Fried-Electronics/FE2202-DRV8876-Breakout/KiCad/Pictures/221005 - 3D Rendering Angled.png

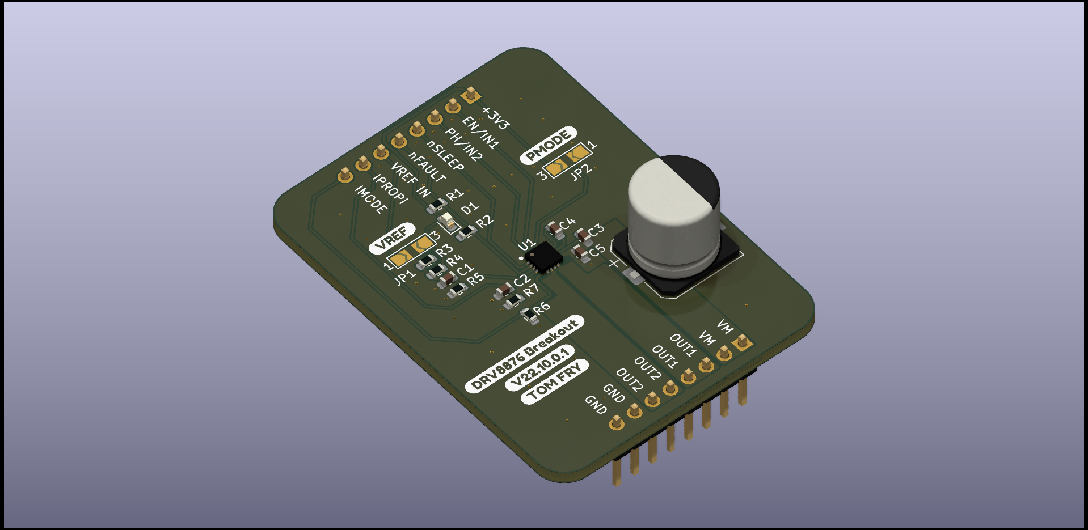
KiCad/Pictures/221005 - 3D Rendering Angled.png
