Fried-Electronics/FE2202-DRV8876-Breakout/KiCad/Pictures/221005 - Schematic.png

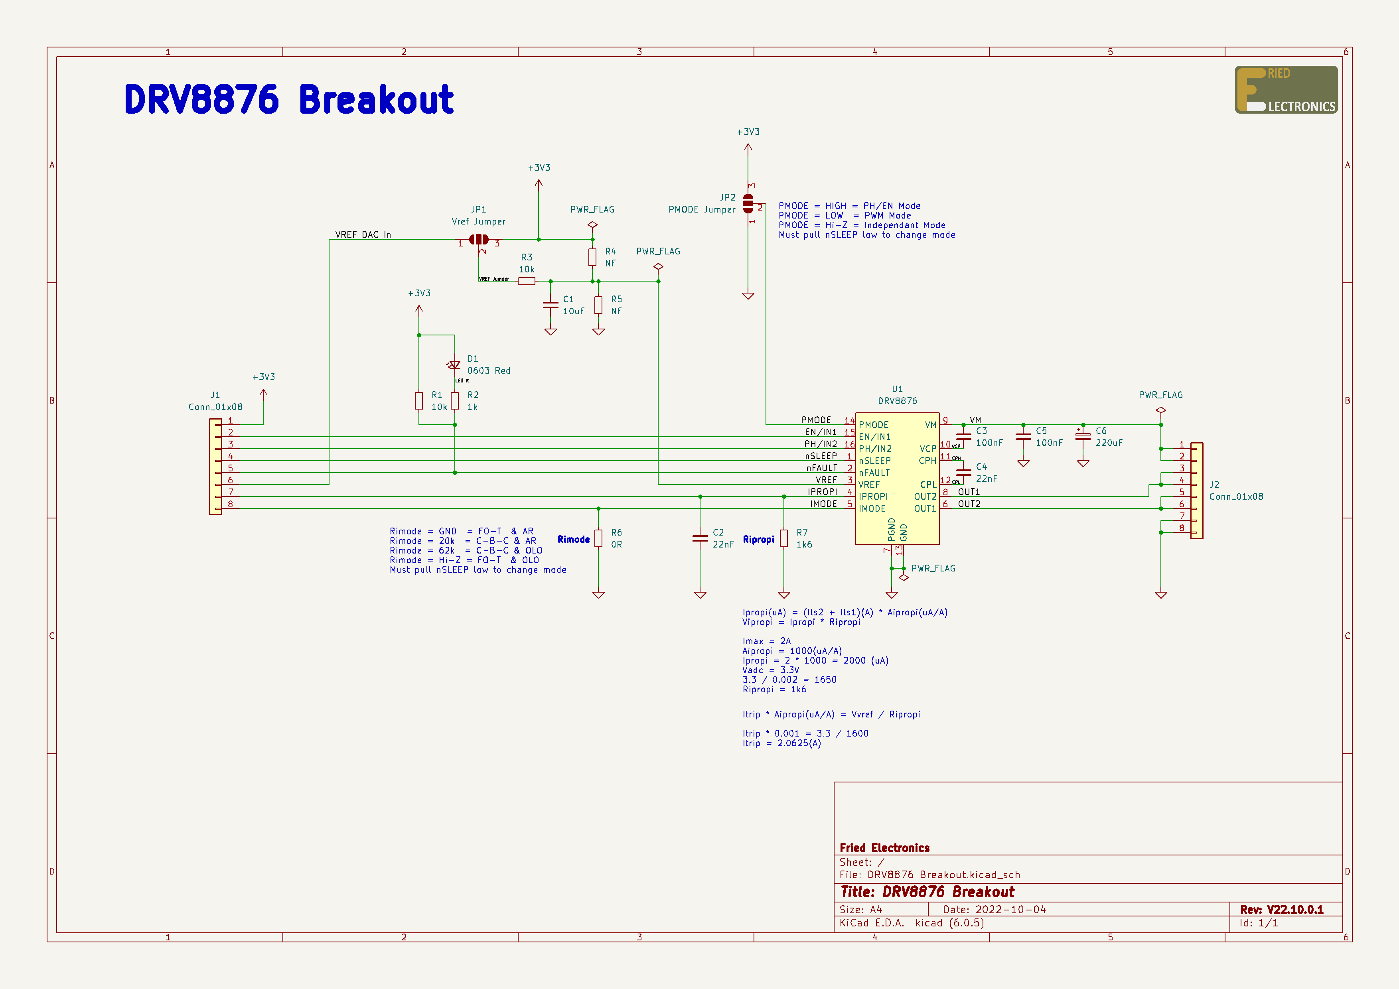
KiCad/Pictures/221005 - Schematic.png
