Fried-Electronics/FE2202-DRV8876-Breakout/KiCad/3D Models/DRV8876 Breakout.step

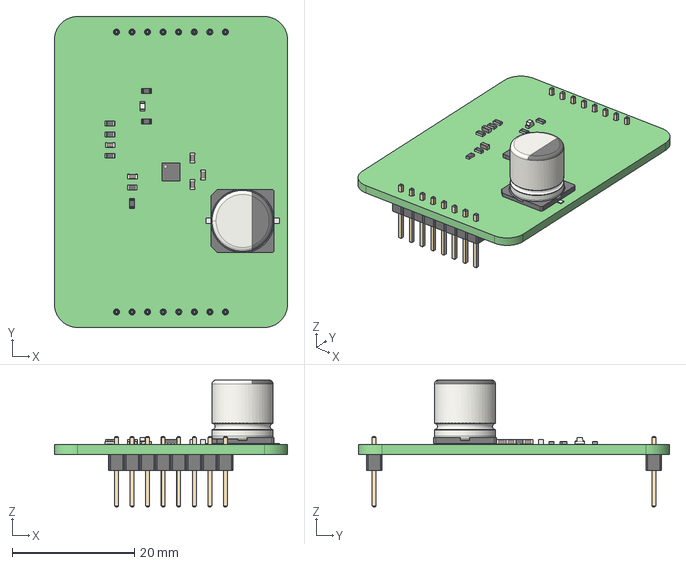
[picture p5: CAD file, 2022-10-05]
KiCad/3D Models/DRV8876 Breakout.step
38.1 x 50.8 x 20.7 mm
_autosave-DRV8876 Breakout PCB
