Fried-Electronics/FE2202-DRV8876-Breakout/KiCad/230410 - Schematic.pdf

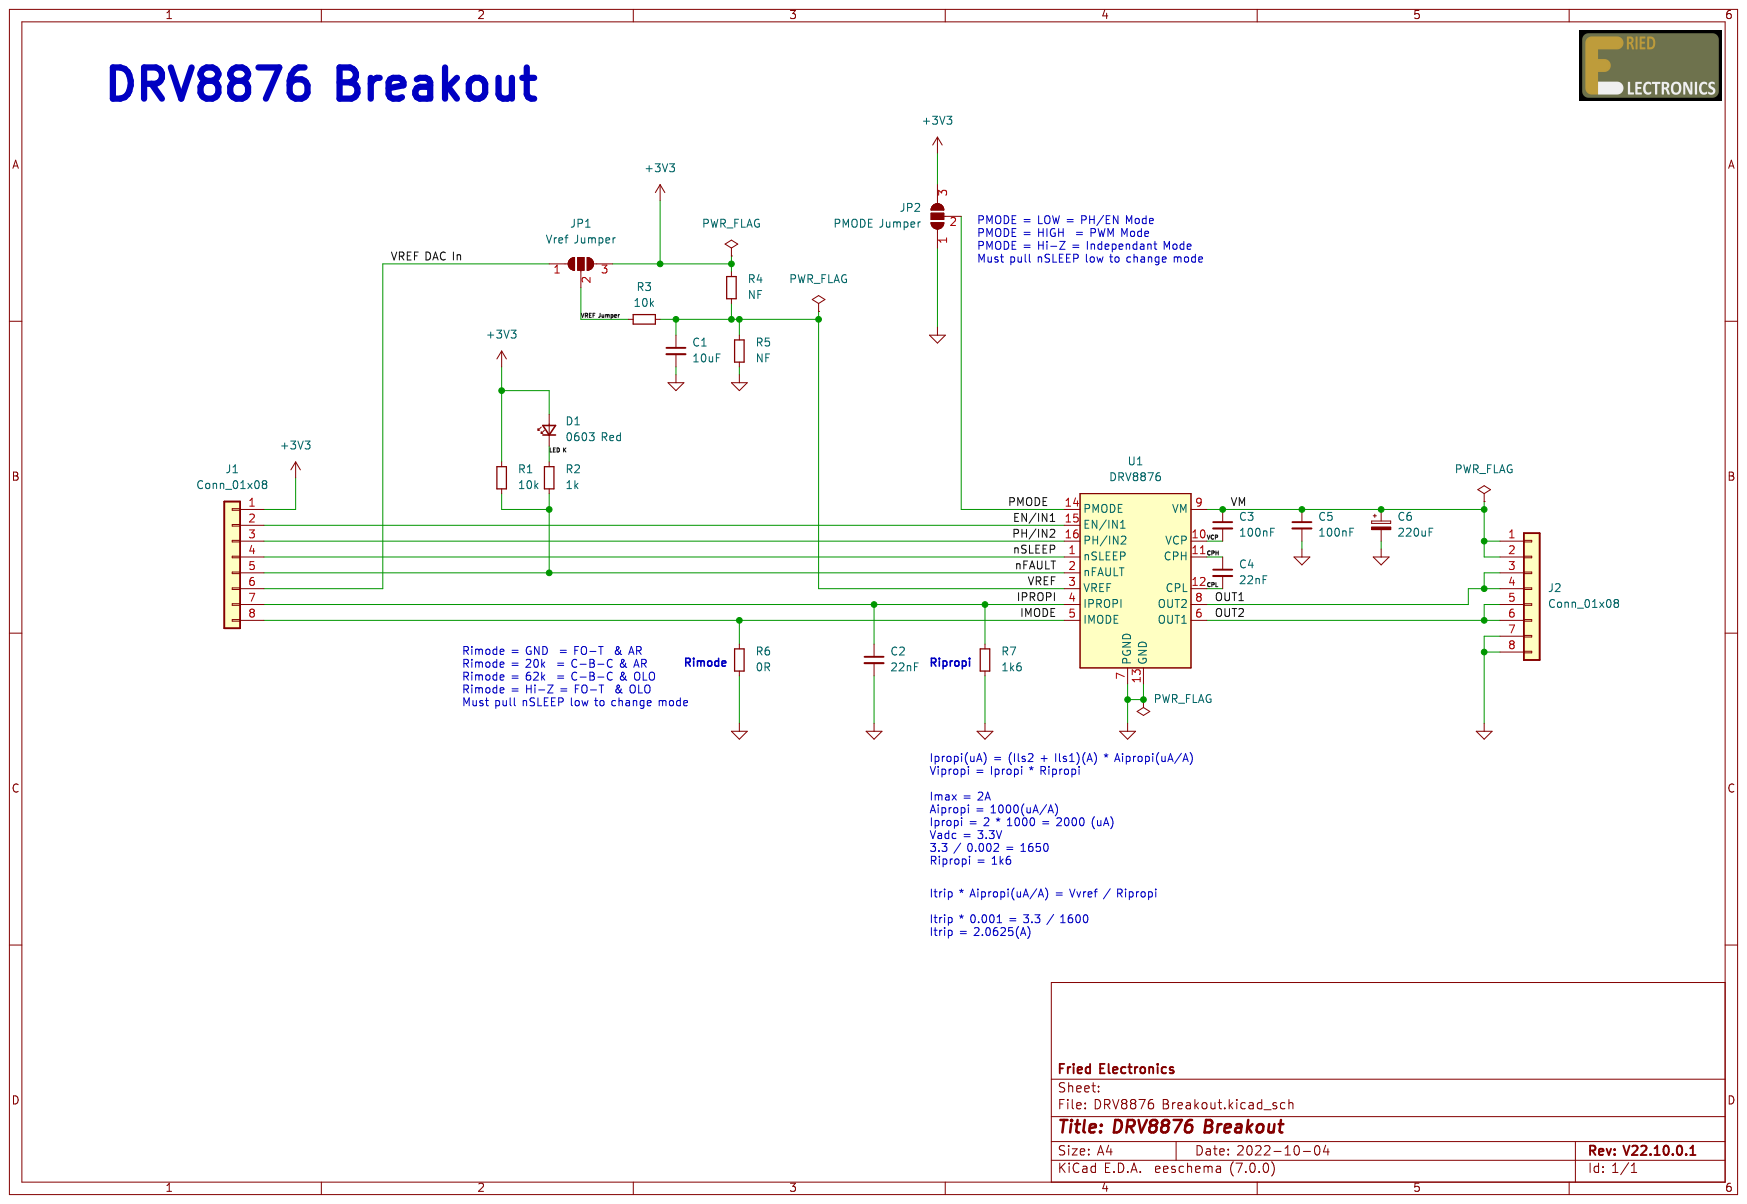
[picture p6: page 1]
