Fried-Electronics/FE2202-DRV8876-Breakout/KiCad/221005 - PCB.pdf

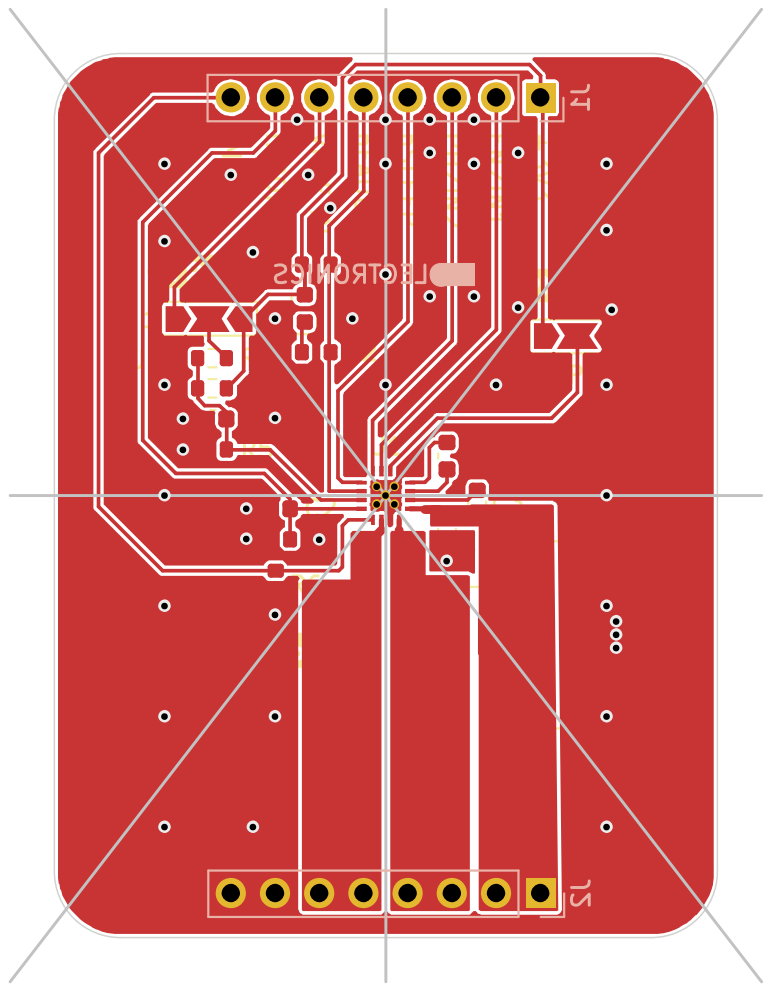
[picture p7: page 1]
