Fried-Electronics/FE2202-DRV8876-Breakout/KiCad/DRV8876 Breakout.kicad_pcb

## KiCad design KiCad/DRV8876 Breakout.kicad_pcb (2022-10-06)

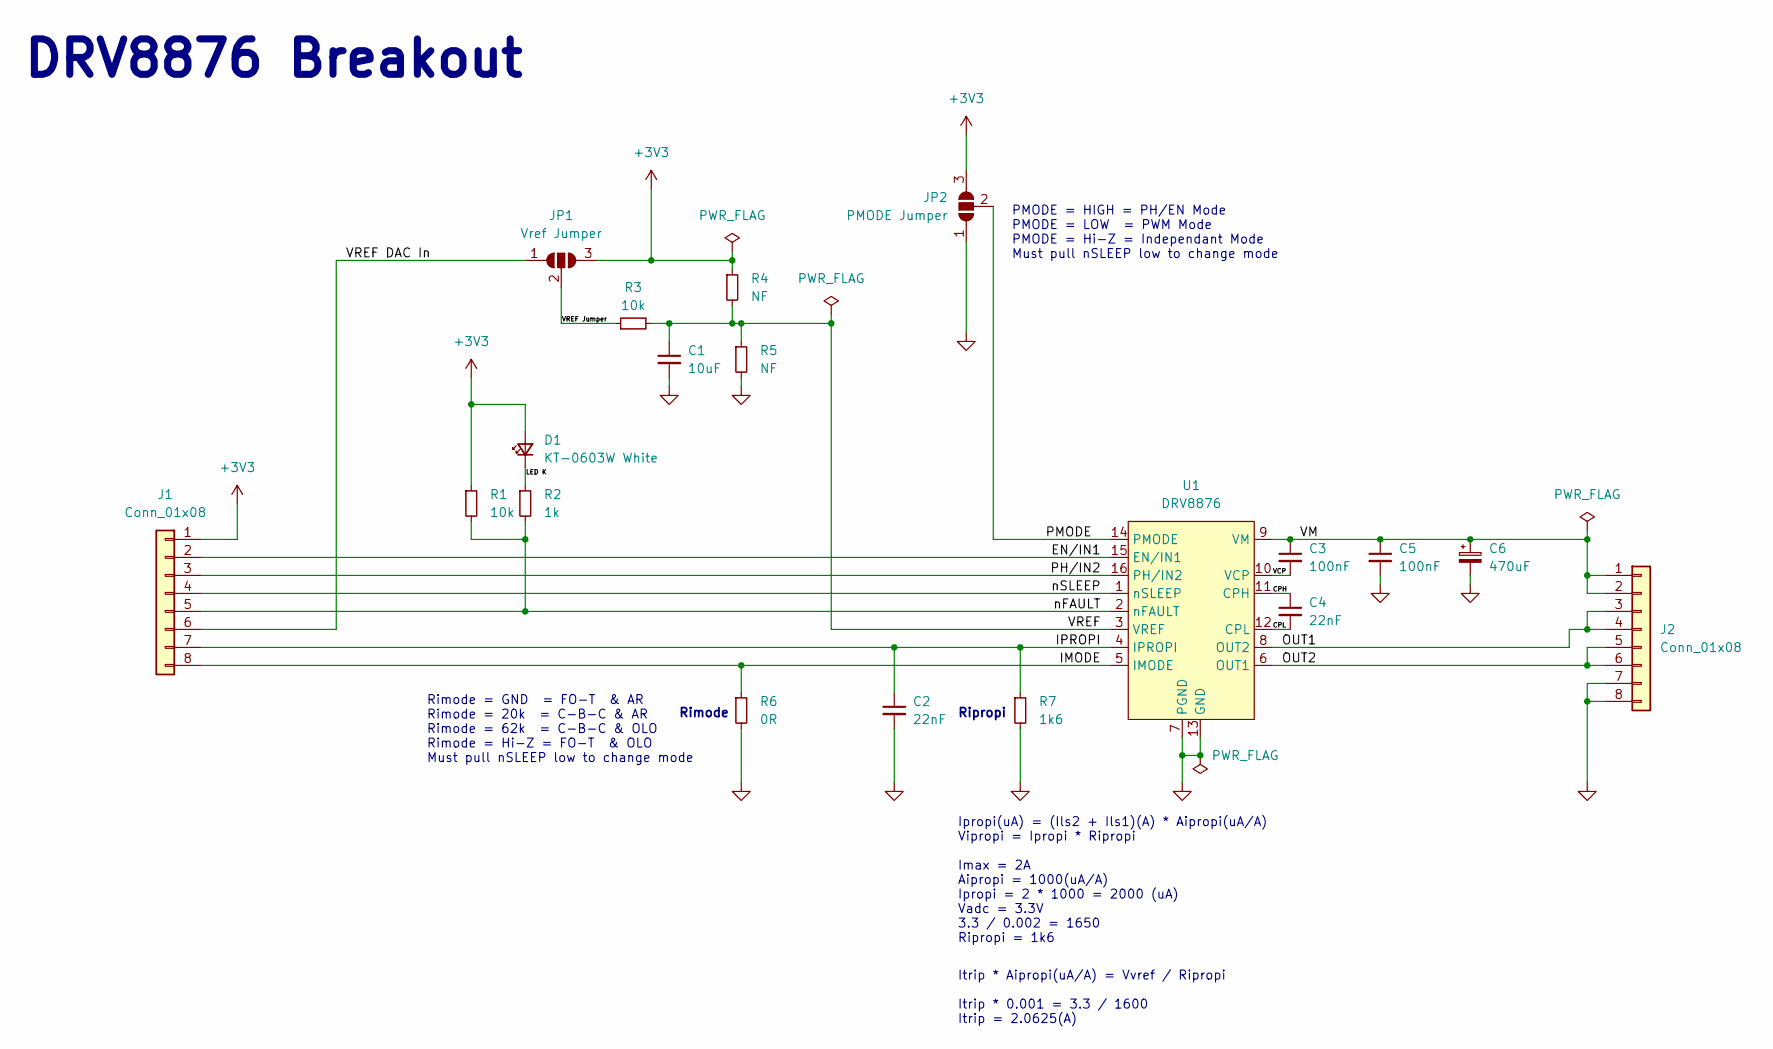
[picture p8: schematic DRV8876 Breakout.kicad_sch]

Parts:
C1: 10uF; C_0603_1608Metric
C2, C4: 22nF; C_0603_1608Metric
C3, C5: 100nF; C_0603_1608Metric
C6: 470uF; CP_Elec_10x10.5
D1: KT-0603W White; LED_0603_1608Metric
J1, J2: Conn_01x08; PinHeader_1x08_P2.54mm_Vertical
JP1: Vref Jumper; SolderJumper-3_P2.0mm_Open_TrianglePad1.0x1.5mm_NumberLabels
JP2: PMODE Jumper; SolderJumper-3_P2.0mm_Open_TrianglePad1.0x1.5mm_NumberLabels
R1, R3: 10k; R_0603_1608Metric
R2: 1k; R_0603_1608Metric
R4, R5: NF; R_0603_1608Metric
R6: 0R; R_0603_1608Metric
R7: 1k6; R_0603_1608Metric
U1: DRV8876; VQFN16 DRV8876

Connections:
+3V3: D1.2 (A), J1.1, JP1.3 (B), JP2.3 (B), R1.1, R4.1
/CPH: C4.1, U1.11 (CPH)
/CPL: C4.2, U1.12 (CPL)
/EN/IN1: J1.2, U1.15 (EN/IN1)
/IMODE: J1.8, R6.1, U1.5 (IMODE)
/IPROPI: C2.1, J1.7, R7.1, U1.4 (IPROPI)
/LED K: D1.1 (K), R2.1
/OUT1: J2.3, J2.4, U1.8 (OUT2)
/OUT2: J2.5, J2.6, U1.6 (OUT1)
/PH/IN2: J1.3, U1.16 (PH/IN2)
/PMODE: JP2.2 (C), U1.14 (PMODE)
/VCP: C3.2, U1.10 (VCP)
/VM: C3.1, C5.1, C6.1, J2.1, J2.2, U1.9 (VM)
/VREF: C1.1, R3.2, R4.2, R5.1, U1.3 (VREF)
/VREF DAC In: J1.6, JP1.1 (A)
/VREF Jumper: JP1.2 (C), R3.1
/nFAULT: J1.5, R1.2, R2.2, U1.2 (nFAULT)
/nSLEEP: J1.4, U1.1 (nSLEEP)
GND: C1.2, C2.2, C5.2, C6.2, J2.7, J2.8, JP2.1 (A), R5.2, R6.2, R7.2, U1.7 (PGND), U1.13 (GND)

Notes on the sheet:
Ipropi(uA) = (Ils2 + Ils1)(A) * Aipropi(uA/A) Vipropi = Ipropi * Ripropi Imax = 2A Aipropi = 1000(uA/A) Ipropi = 2 * 1000 = 2000 (uA) Vadc = 3.3V 3.3 / 0.002 = 1650 Ripropi = 1k6
Rimode = GND = FO-T & AR Rimode = 20k = C-B-C & AR Rimode = 62k = C-B-C & OLO Rimode = Hi-Z = FO-T & OLO Must pull nSLEEP low to change mode
Rimode
PMODE = HIGH = PH/EN Mode PMODE = LOW = PWM Mode PMODE = Hi-Z = Independant Mode Must pull nSLEEP low to change mode
Itrip * Aipropi(uA/A) = Vvref / Ripropi Itrip * 0.001 = 3.3 / 1600 Itrip = 2.0625(A)
Ripropi
DRV8876 Breakout

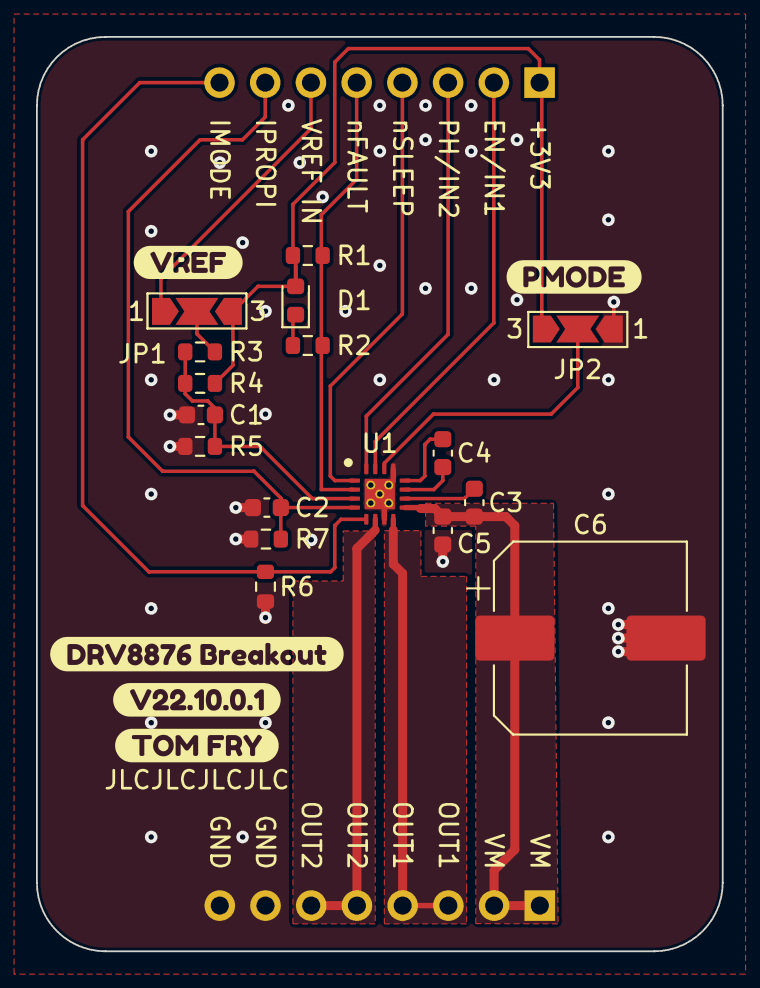
[picture p9: board DRV8876 Breakout.kicad_pcb from above]

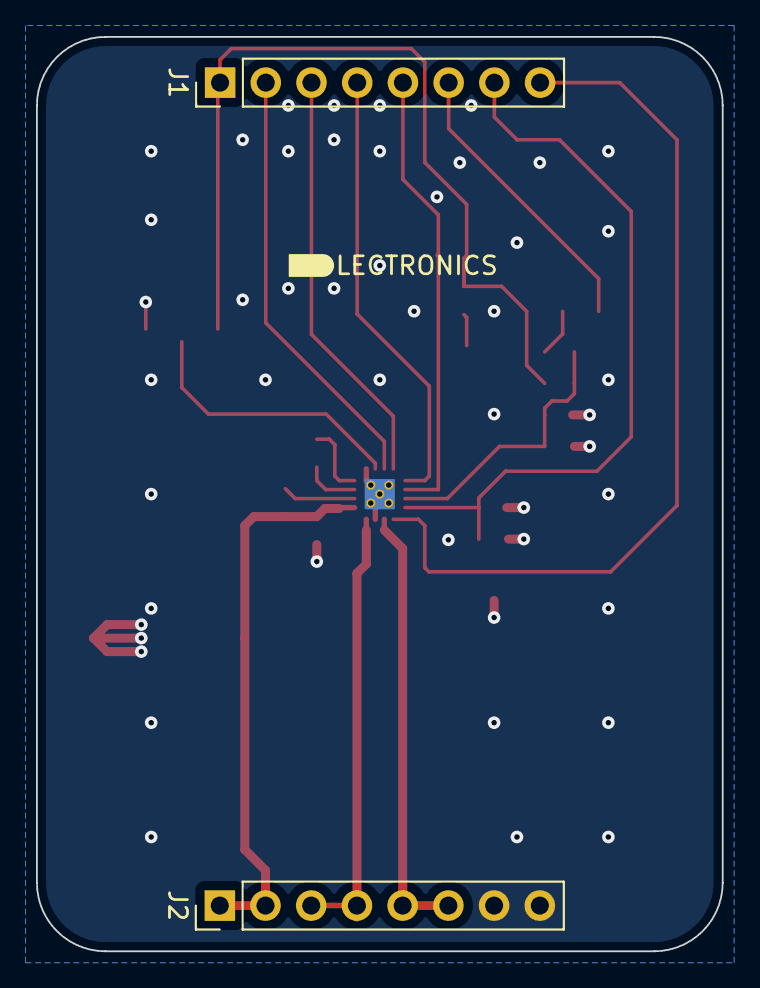
[picture p10: board DRV8876 Breakout.kicad_pcb from below]

Board: 2 copper layers, 38.1 x 50.8 mm, 24 parts (2 on the bottom side), 19 nets.

Other parts of the board:
kibuzzard-633DB2C4: G***; kibuzzard-633DB2C4
kibuzzard-633DB2E1: G***; kibuzzard-633DB2E1
kibuzzard-633DB48A: G***; kibuzzard-633DB48A
kibuzzard-633DB49D: G***; kibuzzard-633DB49D
kibuzzard-633DB301: G***; kibuzzard-633DB301
