Fried-Electronics/FE2202-DRV8876-Breakout/STM32 Software/MEPOS STM32F405RGT6/Core/Inc/main.h

#define DRV1_IPROPI_Pin GPIO_PIN_0
#define DRV1_IPROPI_GPIO_Port GPIOA
#define DRV2_IPROPI_Pin GPIO_PIN_1
#define DRV2_IPROPI_GPIO_Port GPIOA
#define DRV1_FB_Pin GPIO_PIN_2
#define DRV1_FB_GPIO_Port GPIOA
#define DRV2_FB_Pin GPIO_PIN_3
#define DRV2_FB_GPIO_Port GPIOA
#define DRV2_IN1_Pin GPIO_PIN_0
#define DRV2_IN1_GPIO_Port GPIOB
#define DRV2_IN2_Pin GPIO_PIN_1
#define DRV2_IN2_GPIO_Port GPIOB
#define DRV1_IN1_Pin GPIO_PIN_6
#define DRV1_IN1_GPIO_Port GPIOC
#define DRV1_IN2_Pin GPIO_PIN_7
#define DRV1_IN2_GPIO_Port GPIOC
#define nSLEEP_Pin GPIO_PIN_8
#define nSLEEP_GPIO_Port GPIOA
