Fried-Electronics/FE2202-DRV8876-Breakout/(commit log)

2022-10-04 Create DRV8876 Breakout.kicad_pcb
    [DRV8876 Breakout.kicad_pcb]
2022-10-04 Create DRV8876 Breakout.kicad_pro
2022-10-04 Create DRV8876 Breakout.kicad_sch
    [DRV8876 Breakout.kicad_sch]
2022-10-04 Updated Kicad files
    [DRV8876 Breakout.kicad_pcb, DRV8876 Breakout.kicad_sch]
2022-10-05 Finished Schematic and PCB
    [DRV8876 Breakout.kicad_pcb, DRV8876 Breakout.kicad_sch]
2022-10-05 Finished and Plotted
    [DRV8876 Breakout-B_Cu.gbr, DRV8876 Breakout-B_Mask.gbr, DRV8876 Breakout-B_Paste.gbr, DRV8876 Breakout-B_Silkscreen.gbr, DRV8876 Breakout-Edge_Cuts.gbr, DRV8876 Breakout-F_Cu.gbr, DRV8876 Breakout-F_Mask.gbr, DRV8876 Breakout-F_Paste.gbr]
2022-10-06 Update 221005 - Schematic.pdf
2022-10-06 Update DRV8876 Breakout.kicad_sch
    [DRV8876 Breakout.kicad_sch]
2022-10-06 Update 221005 - Schematic.png
2022-10-06 Create DRV8876 Breakout BOM.csv
    [DRV8876 Breakout BOM.csv]
2022-10-06 Create DRV8876 Breakout-bottom-pos.csv
    [DRV8876 Breakout-bottom-pos.csv]
2022-10-06 Create DRV8876 Breakout-top-pos.csv
    [DRV8876 Breakout-top-pos.csv]
2022-10-06 Update DRV8876 Breakout.kicad_pcb
    [DRV8876 Breakout.kicad_pcb]
2022-10-06 Update DRV8876 Breakout BOM.csv
    [DRV8876 Breakout BOM.csv]
2022-11-04 Created STM32 Software Folder
2023-04-10 Updated PMODE on schematic as was wrong
