Fried-Electronics/FE2202-DRV8876-Breakout/(notices)

Notices in the files:
STM32 Software/MEPOS STM32F405RGT6/Core/Inc/main.h:
Copyright (c) 2022 STMicroelectronics.
All rights reserved.
This software is licensed under terms that can be found in the LICENSE file
